mdaub/modular-vfd/README.md

# modular-vfd
A design for a modular vacuum fluorescent display using IV-11 VFD tubes
