mdaub/modular-vfd/Modular_VFD_V2_Enclosure.dxf

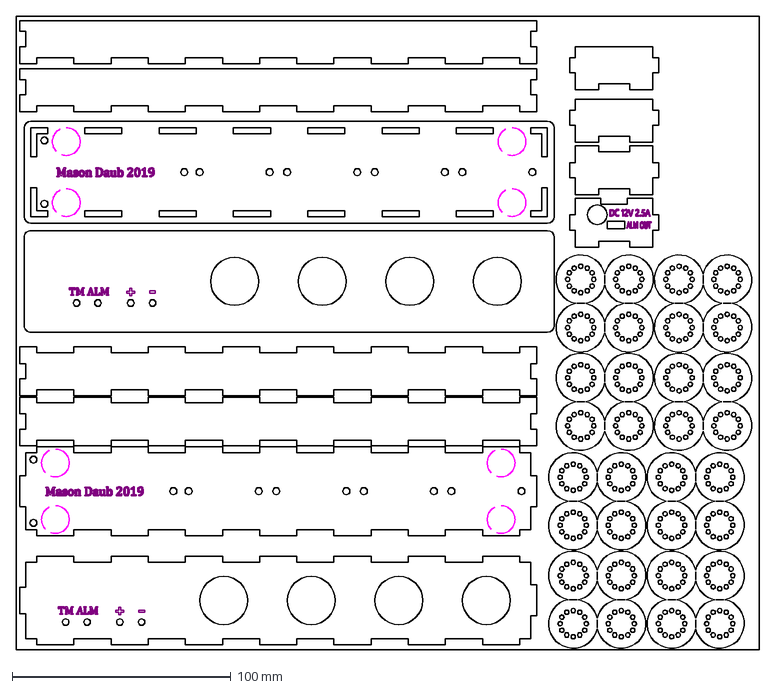
[picture p1: CAD file, 2019-11-24]
Modular_VFD_V2_Enclosure.dxf
340.0 x 290.0 mm
