mdaub/modular-vfd/Modular_VFD_V2_Enclosure_3mm.dxf

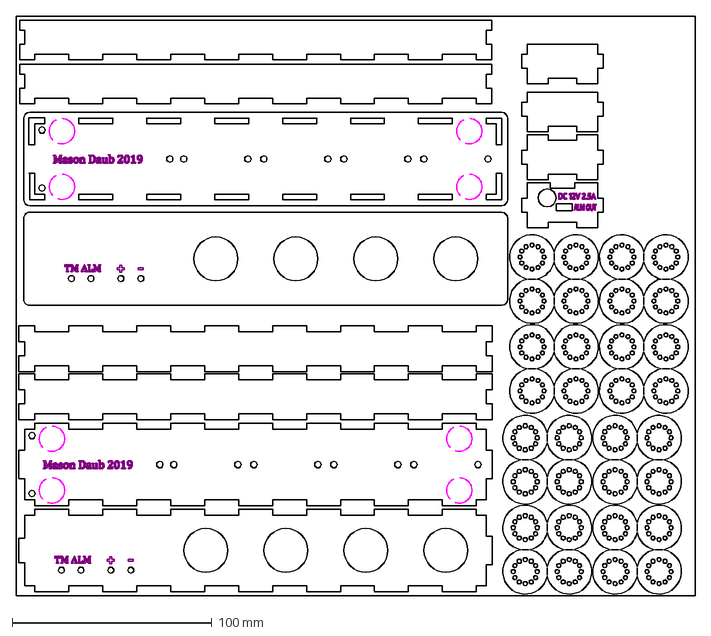
[picture p2: CAD file, 2019-11-24]
Modular_VFD_V2_Enclosure_3mm.dxf
340.0 x 290.0 mm
