mdaub/modular-vfd/VFD PSU V2.brd

## EAGLE design VFD PSU V2.brd (2019-11-23)

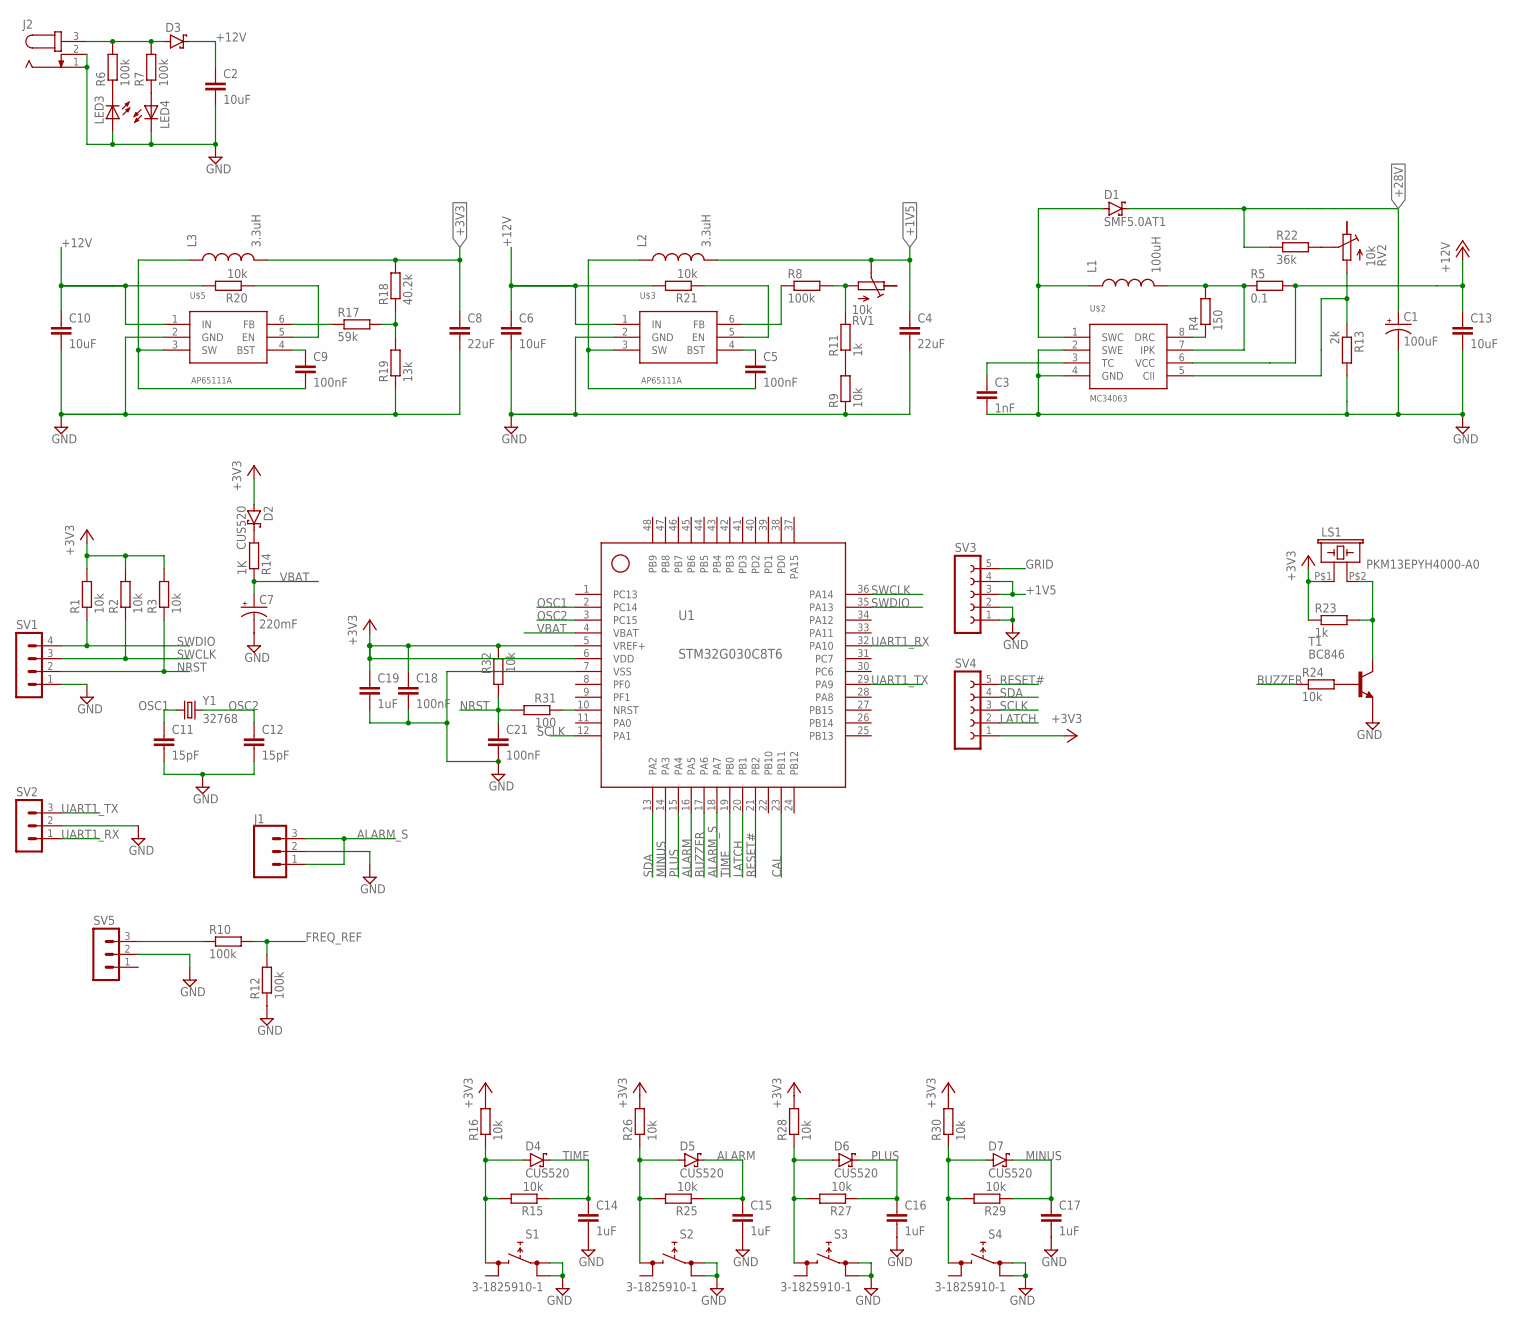
[picture p3: schematic VFD PSU V2.sch]

Parts:
C1: 100uF; PANASONIC_C
C2, C6, C10, C13: 10uF; C0805
C3: 1nF; C0603
C4, C8: 22uF; C0805
C5, C9, C18, C21: 100nF; C0603
C7: 220mF; 4.8-COINCELL-SCAP
C11, C12: 15pF; C0402
C14, C15, C16, C17, C19: 1uF; C0603
D1: SMF5.0AT1; SOD123FL
D2, D4, D5, D6, D7: CUS520; SOD323_ST
D3: SCHOTTKY-DIODESMD; SMB
J1: CONN_03JST-PTH-NS; JST-3-PTH-NS
J2: JACK-PLUG0; SPC4077
L1: 100uH; 2-SMD
L2, L3: 3.3uH; 1008
LED3, LED4: LEDSMT1206; 1206
LS1: PKM13EPYH4000-A0
R1, R2, R3, R9, R15, R16, R20, R21, R24, R25, R26, R27, R28, R29, R30, R32: 10k; R0603
R4: 150; R0603
R5: 0.1; R0805
R6, R7, R8, R10, R12: 100k; R0603
R11, R23: 1k; R0603
R13: 2k; R0603
R14: 1K; R0603
R17: 59k; R0603
R18: 40.2k; R0603
R19: 13k; R0603
R22: 36k; R0603
R31: 100; R0603
RV1, RV2: 10k; TC33X-2
S1, S2, S3, S4: 3-1825910-1; PANASONISWITCH
SV1: MA04-1
SV2, SV5: MA03-1
SV3, SV4: FE05W
T1: BC846; SOT23
U1: STM32G030C8T6; LQFP48
U$2: MC34063; SO08
U$3, U$5: AP65111A; TSOT23-6
Y1: 32768; 2-SMD-NO-LEAD-Q

Connections:
+1V5: C4.1, L2.P$2 (2), RV1.P$2 (S), SV3.3, SV3.4
+3V3: C8.1, C18.1, C19.1, D2.A, L3.P$2 (2), LS1.P$1 (1), R1.2, R2.2, R3.2, R16.2, R18.2, R23.1, R26.2, R28.2, R30.2, R32.1, SV4.1, U1.5 (VREF+), U1.6 (VDD)
+12V: C2.1, C6.1, C10.1, C13.1, D3.C, R5.2, R20.2, R21.2, U$2.6 (VCC), U$3.1 (IN), U$5.1 (IN)
+28V: C1.+, D1.C, R22.1
ALARM: C15.1, D5.C, R25.1, U1.16 (PA5)
ALARM_S: J1.1, J1.3, U1.18 (PA7)
BUZZER: R24.1, U1.17 (PA6)
CAL: U1.23 (PB11)
FREQ_REF: R10.2, R12.2
GND: C1.-, C2.2, C3.2, C4.2, C6.2, C7.P$2 (-), C8.2, C10.2, C11.2, C12.2, C13.2, C14.2, C15.2, C16.2, C17.2, C18.2, C19.2, C21.2, J1.2, J2.1, J2.2, LED3.A, LED4.C, R9.1, R12.1, R13.2, R19.1, S1.P$1 (0), S1.P$2 (0), S2.P$1 (0), S2.P$2 (0), S3.P$1 (0), S3.P$2 (0), S4.P$1 (0), S4.P$2 (0), SV1.1, SV2.2, SV3.1, SV3.2, SV5.2, T1.2 (E), U1.7 (VSS), U$2.2 (SWE), U$2.4 (GND), U$3.2 (GND), U$5.2 (GND)
GRID: SV3.5
LATCH: SV4.2, U1.20 (PB1)
MINUS: C17.1, D7.C, R29.1, U1.14 (PA3)
unnamed: LED3.C, R6.1
unnamed: LED4.A, R7.1
unnamed: R9.2, R11.1
unnamed: R8.1, U$3.6 (FB)
unnamed: L1.P$2 (2), R4.2, R5.1, U$2.7 (IPK)
unnamed: D3.A, J2.3, R6.2, R7.2
unnamed: R4.1, U$2.8 (DRC)
unnamed: R21.1, U$3.5 (EN)
unnamed: C5.2, L2.P$1 (1), U$3.3 (SW)
unnamed: C5.1, U$3.4 (BST)
unnamed: R8.2, R11.2, RV1.P$1 (E)
unnamed: D1.A, L1.P$1 (1), U$2.1 (SWC)
unnamed: R22.2, RV2.P$2 (S)
unnamed: C3.1, U$2.3 (TC)
unnamed: R10.1, SV5.3
unnamed: R20.1, U$5.5 (EN)
unnamed: C9.2, L3.P$1 (1), U$5.3 (SW)
unnamed: C9.1, U$5.4 (BST)
unnamed: D4.A, R15.2, R16.1, S1.P$3 (1)
unnamed: R17.1, U$5.6 (FB)
unnamed: R17.2, R18.1, R19.2
unnamed: R13.1, RV2.P$1 (E), U$2.5 (CII)
unnamed: D2.C, R14.2
unnamed: LS1.P$2 (2), R23.2, T1.3 (C)
unnamed: R24.2, T1.1 (B)
unnamed: D5.A, R25.2, R26.1, S2.P$3 (1)
unnamed: R31.1, U1.10 (NRST)
unnamed: D6.A, R27.2, R28.1, S3.P$3 (1)
unnamed: D7.A, R29.2, R30.1, S4.P$3 (1)
NRST: C21.1, R3.1, R31.2, R32.2, SV1.2
OSC1: C11.1, U1.2 (PC14), Y1.P$1 (1)
OSC2: C12.1, U1.3 (PC15), Y1.P$2 (2)
PLUS: C16.1, D6.C, R27.1, U1.15 (PA4)
RESET#: SV4.5, U1.21 (PB2)
SCLK: SV4.3, U1.12 (PA1)
SDA: SV4.4, U1.13 (PA2)
SWCLK: R2.1, SV1.3, U1.36 (PA14)
SWDIO: R1.1, SV1.4, U1.35 (PA13)
TIME: C14.1, D4.C, R15.1, U1.19 (PB0)
UART1_RX: SV2.1, U1.32 (PA10)
UART1_TX: SV2.3, U1.29 (PA9)
VBAT: C7.P$1 (+), R14.1, U1.4 (VBAT)

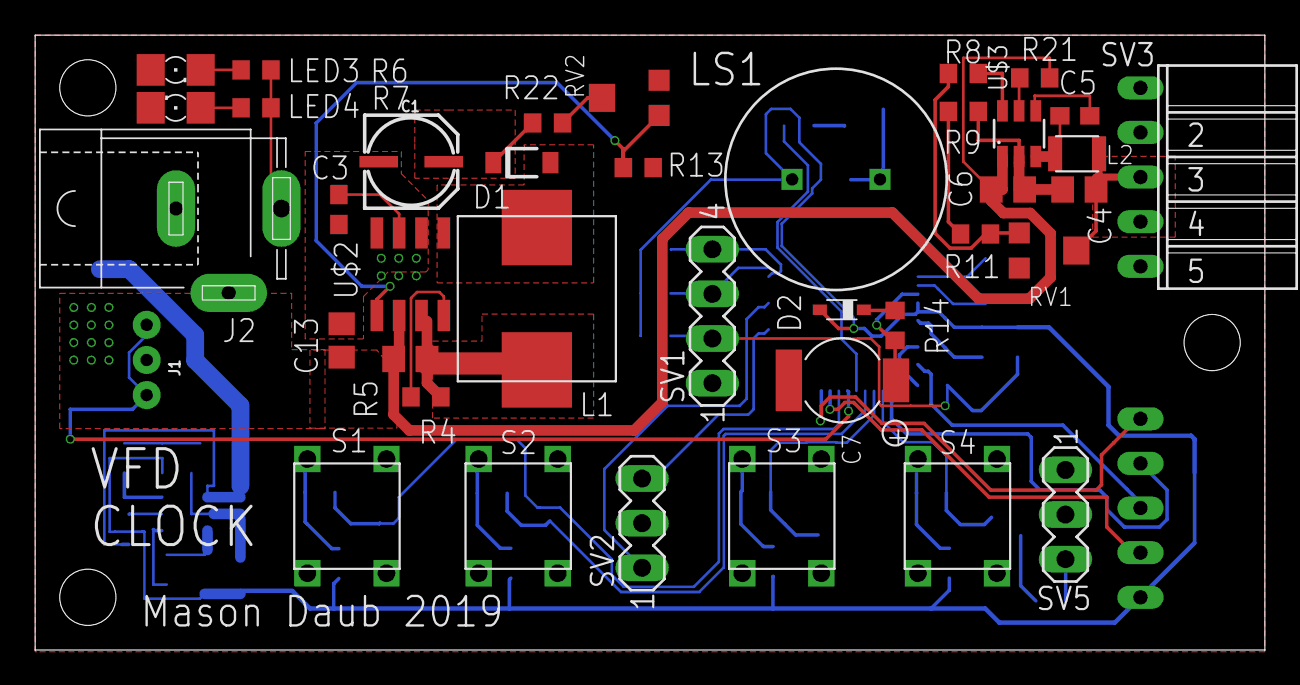
[picture p4: board VFD PSU V2.brd from above]

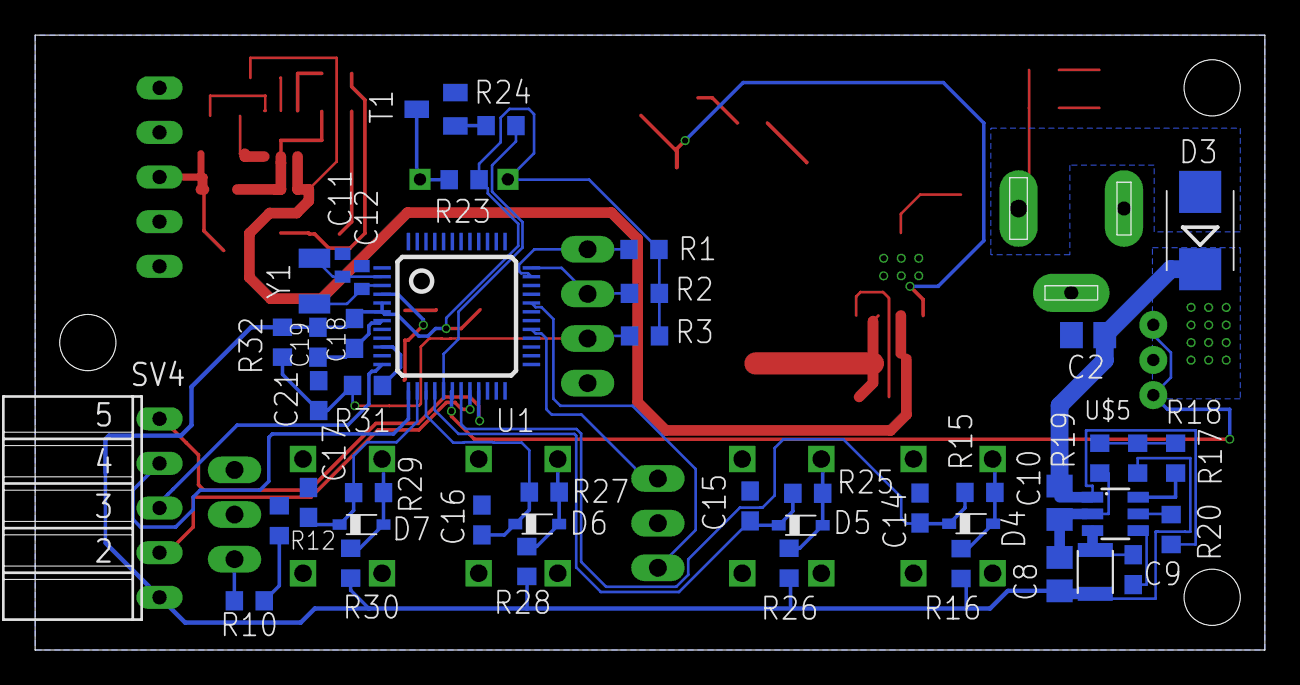
[picture p5: board VFD PSU V2.brd from below]

Board: 2 copper layers, 70.0 x 35.0 mm, 84 parts (45 on the bottom side), 53 nets.
