mdaub/modular-vfd/VFD Board.brd

## EAGLE design VFD Board.brd (2019-11-23)

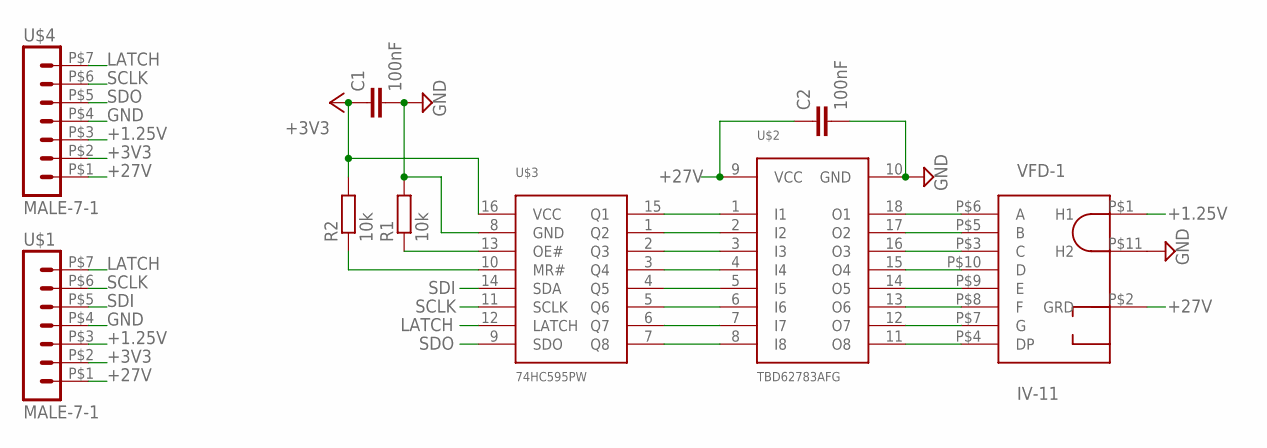
[picture p6: schematic VFD Board.sch]

Parts:
C1, C2: 100nF; C0603
R1, R2: 10k; R0603
U$1, U$4: MALE-7-1; 7-PIN-HEADER
U$2: TBD62783AFG; SOIC18L
U$3: 74HC595PW; TSSOP16
VFD-1: IV-11

Connections:
+1.25V: U$1.P$3 (3), U$4.P$3 (3), VFD-1.P$1 (H1)
+3V3: C1.1, R2.2, U$1.P$2 (2), U$3.16 (VCC), U$4.P$2 (2)
+27V: C2.1, U$1.P$1 (1), U$2.9 (VCC), U$4.P$1 (1), VFD-1.P$2 (GRD)
GND: C1.2, C2.2, R1.2, U$1.P$4 (4), U$2.10 (GND), U$3.8 (GND), U$4.P$4 (4), VFD-1.P$11 (H2)
LATCH: U$1.P$7 (7), U$3.12 (LATCH), U$4.P$7 (7)
unnamed: U$2.1 (I1), U$3.15 (Q1)
unnamed: U$2.2 (I2), U$3.1 (Q2)
unnamed: U$2.3 (I3), U$3.2 (Q3)
unnamed: U$2.4 (I4), U$3.3 (Q4)
unnamed: U$2.5 (I5), U$3.4 (Q5)
unnamed: U$2.6 (I6), U$3.5 (Q6)
unnamed: U$2.7 (I7), U$3.6 (Q7)
unnamed: U$2.8 (I8), U$3.7 (Q8)
unnamed: U$2.18 (O1), VFD-1.P$6 (A)
unnamed: U$2.17 (O2), VFD-1.P$5 (B)
unnamed: U$2.16 (O3), VFD-1.P$3 (C)
unnamed: U$2.15 (O4), VFD-1.P$10 (D)
unnamed: U$2.14 (O5), VFD-1.P$9 (E)
unnamed: U$2.13 (O6), VFD-1.P$8 (F)
unnamed: U$2.12 (O7), VFD-1.P$7 (G)
unnamed: U$2.11 (O8), VFD-1.P$4 (DP)
unnamed: R1.1, U$3.13 (OE#)
unnamed: R2.1, U$3.10 (MR#)
SCLK: U$1.P$6 (6), U$3.11 (SCLK), U$4.P$6 (6)
SDI: U$1.P$5 (5), U$3.14 (SDA)
SDO: U$3.9 (SDO), U$4.P$5 (5)

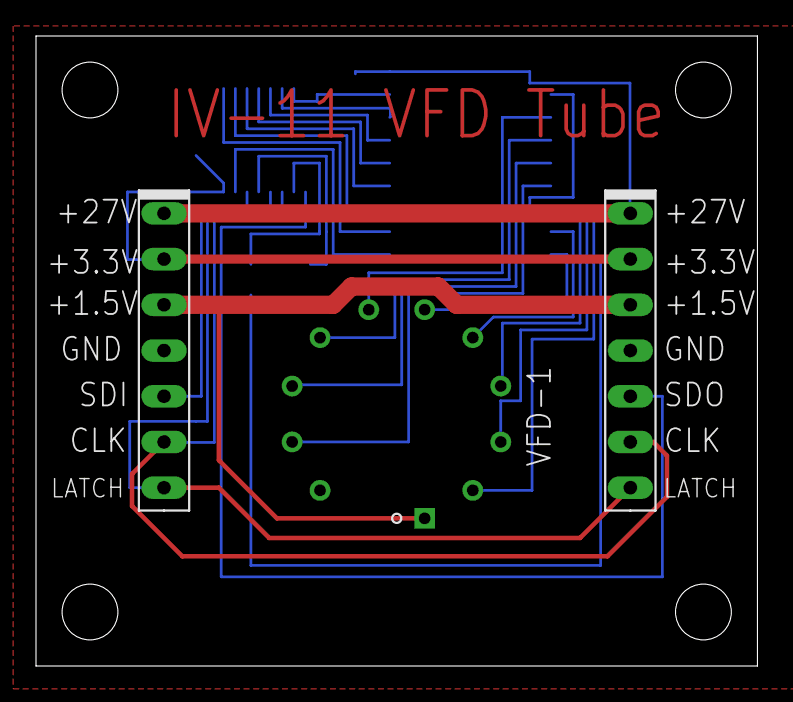
[picture p7: board VFD Board.brd from above]

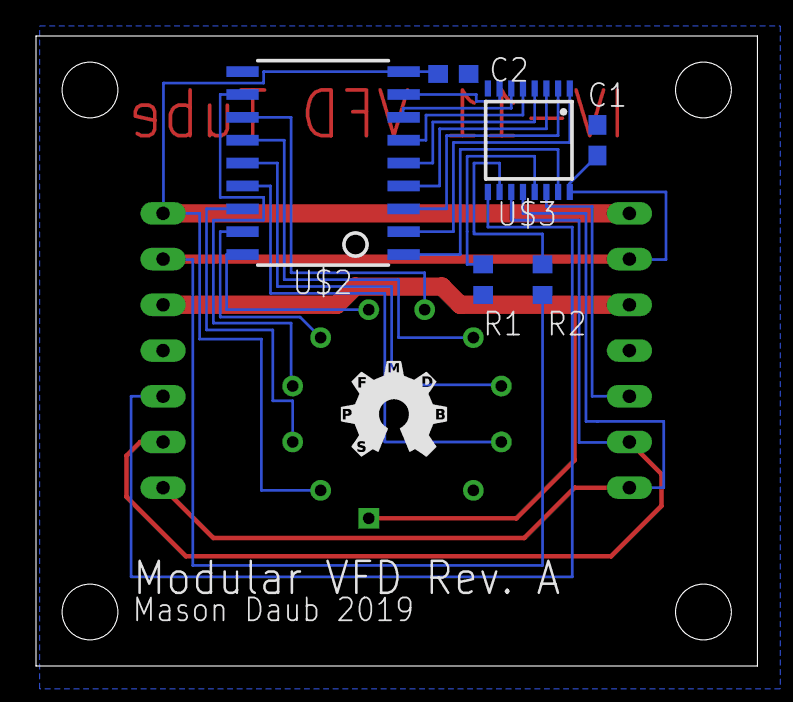
[picture p8: board VFD Board.brd from below]

Board: 2 copper layers, 40.1 x 35.0 mm, 9 parts (6 on the bottom side), 26 nets.
