mdaub/modular-vfd/VFD Board V2.brd

## EAGLE design VFD Board V2.brd (2019-11-23)

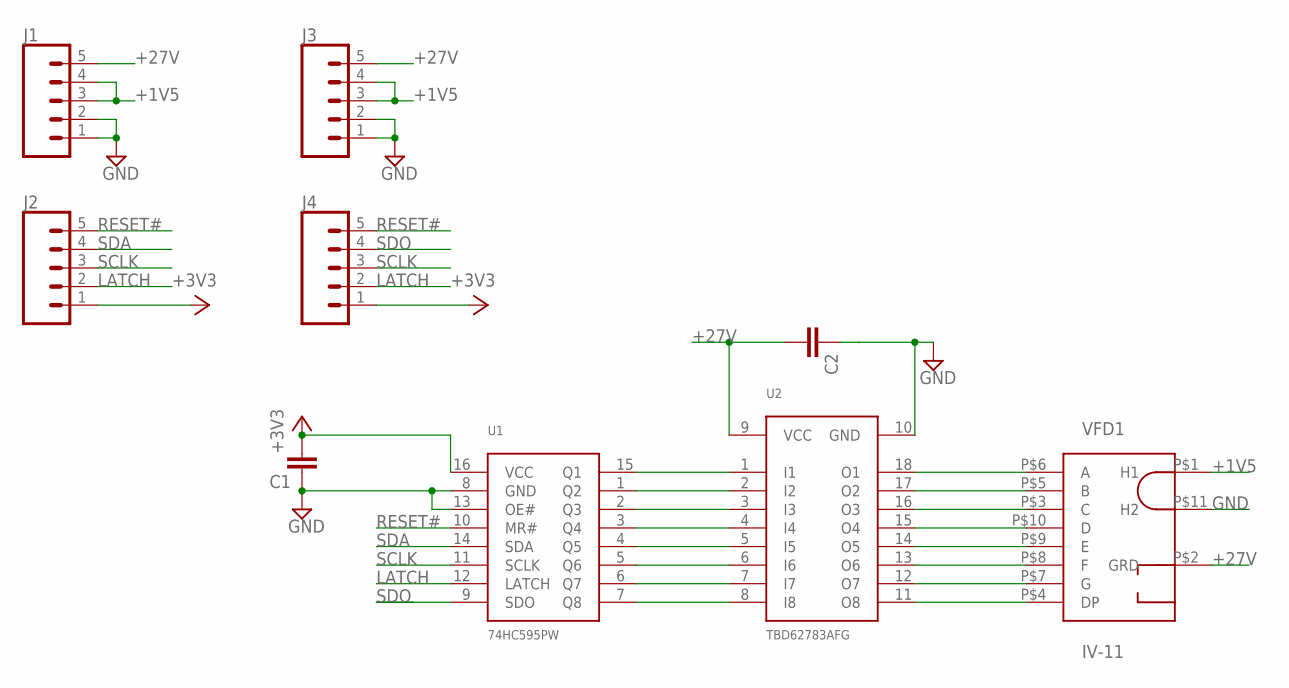
[picture p9: schematic VFD Board V2.sch]

Parts:
C1, C2: C-EUC0603; C0603
J1, J2, J3, J4: CONN_05NO_SILK; 1X05_NO_SILK
U1: 74HC595PW; TSSOP16
U2: TBD62783AFG; SOIC18L
VFD1: IV-11

Connections:
+1V5: J1.3, J1.4, J3.3, J3.4, VFD1.P$1 (H1)
+3V3: C1.2, J2.1, J4.1, U1.16 (VCC)
+27V: C2.2, J1.5, J3.5, U2.9 (VCC), VFD1.P$2 (GRD)
GND: C1.1, C2.1, J1.1, J1.2, J3.1, J3.2, U1.8 (GND), U1.13 (OE#), U2.10 (GND), VFD1.P$11 (H2)
LATCH: J2.2, J4.2, U1.12 (LATCH)
unnamed: U2.18 (O1), VFD1.P$6 (A)
unnamed: U1.7 (Q8), U2.8 (I8)
unnamed: U1.6 (Q7), U2.7 (I7)
unnamed: U1.5 (Q6), U2.6 (I6)
unnamed: U1.4 (Q5), U2.5 (I5)
unnamed: U1.3 (Q4), U2.4 (I4)
unnamed: U1.2 (Q3), U2.3 (I3)
unnamed: U1.1 (Q2), U2.2 (I2)
unnamed: U1.15 (Q1), U2.1 (I1)
unnamed: U2.17 (O2), VFD1.P$5 (B)
unnamed: U2.16 (O3), VFD1.P$3 (C)
unnamed: U2.15 (O4), VFD1.P$10 (D)
unnamed: U2.14 (O5), VFD1.P$9 (E)
unnamed: U2.13 (O6), VFD1.P$8 (F)
unnamed: U2.12 (O7), VFD1.P$7 (G)
unnamed: U2.11 (O8), VFD1.P$4 (DP)
RESET#: J2.5, J4.5, U1.10 (MR#)
SCLK: J2.3, J4.3, U1.11 (SCLK)
SDA: J2.4, U1.14 (SDA)
SDO: J4.4, U1.9 (SDO)

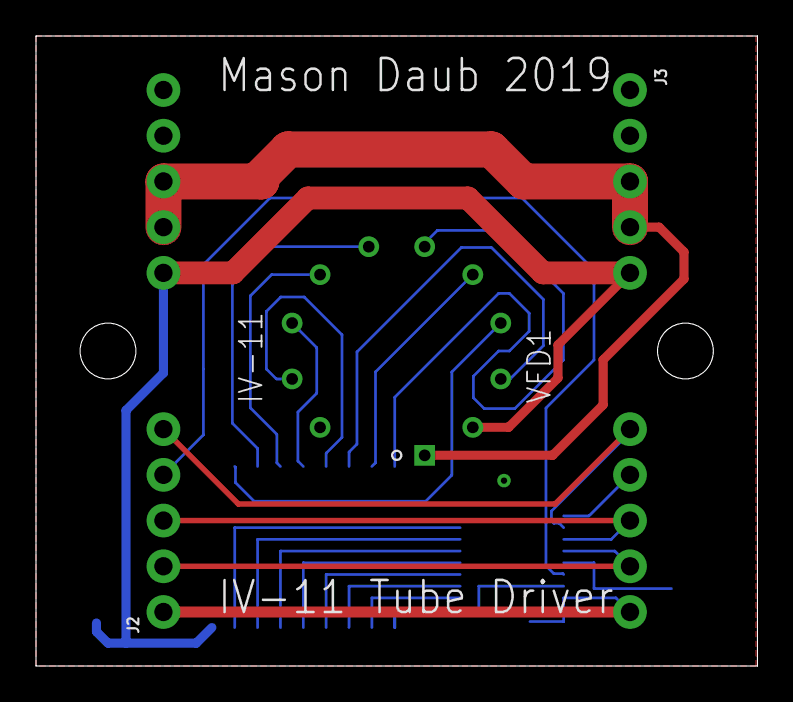
[picture p10: board VFD Board V2.brd from above]

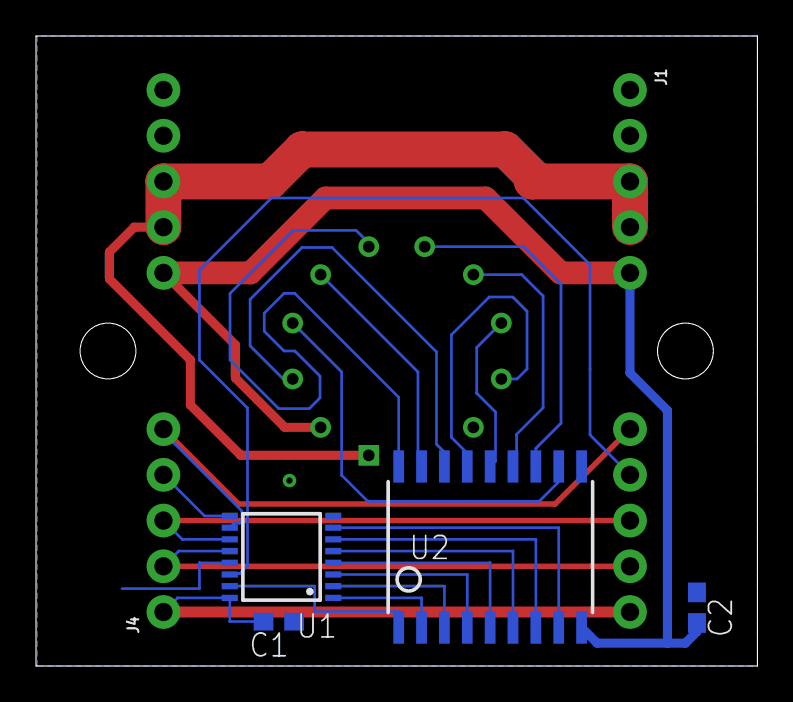
[picture p11: board VFD Board V2.brd from below]

Board: 2 copper layers, 40.1 x 35.0 mm, 9 parts (6 on the bottom side), 25 nets.
