mdaub/modular-vfd/VFD PSU.brd

## EAGLE design VFD PSU.brd (2019-11-23)

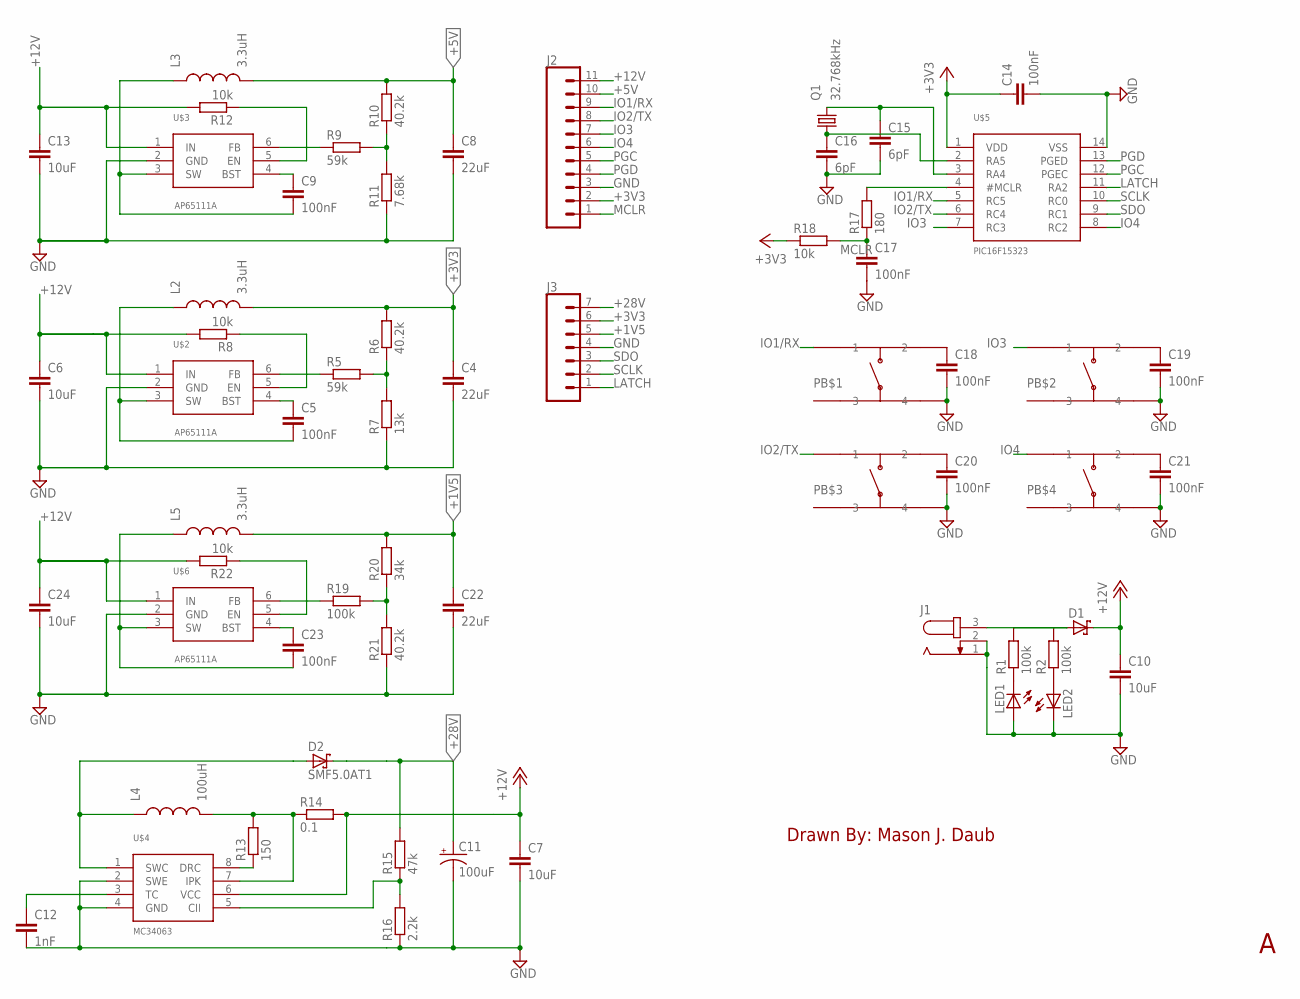
[picture p12: schematic VFD PSU.sch]

Parts:
C4, C8, C22: 22uF; C0805
C5, C9, C14, C17, C18, C19, C20, C21, C23: 100nF; C0603
C6, C7, C10, C13, C24: 10uF; C0805
C11: 100uF; PANASONIC_C
C12: 1nF; C0603
C15, C16: 6pF; C0603
D1: SCHOTTKY-DIODESMD; SMB
D2: SMF5.0AT1; SOD123FL
J1: JACK-PLUG0; SPC4077
J2: CONN_111X11_NO_SILK; 1X11_NO_SILK
J3: CONN_07LONGPADS; 1X07_LONGPADS
L2, L3, L5: 3.3uH; 1008
L4: 100uH; 2-SMD
LED1, LED2: LEDSMT1206; 1206
PB$1, PB$2, PB$3, PB$4: PTS645SM43SMTR92-LFS; SMDTACTILE
Q1: 32.768kHz; 8.2X3.8
R1, R2, R19: 100k; R0603
R5, R9: 59k; R0603
R6, R10, R21: 40.2k; R0603
R7: 13k; R0603
R8, R12, R18, R22: 10k; R0603
R11: 7.68k; R0603
R13: 150; R0603
R14: 0.1; R0805
R15: 47k; R0603
R16: 2.2k; R0603
R17: 180; R0603
R20: 34k; R0603
U$2, U$3, U$6: AP65111A; TSOT23-6
U$4: MC34063; SO08
U$5: PIC16F15323; SO14

Connections:
+1V5: C22.1, J3.5, L5.P$2 (2), R20.2
+3V3: C4.1, C14.1, J2.2, J3.6, L2.P$2 (2), R6.2, R18.1, U$5.1 (VDD)
+5V: C8.1, J2.10, L3.P$2 (2), R10.2
+12V: C6.1, C7.1, C10.1, C13.1, C24.1, D1.C, J2.11, R8.2, R12.2, R14.2, R22.2, U$2.1 (IN), U$3.1 (IN), U$4.6 (VCC), U$6.1 (IN)
+28V: C11.+, D2.C, J3.7, R15.2
GND: C4.2, C6.2, C7.2, C8.2, C10.2, C11.-, C12.2, C13.2, C14.2, C15.2, C16.2, C17.2, C18.2, C19.2, C20.2, C21.2, C22.2, C24.2, J1.1, J1.2, J2.3, J3.4, LED1.A, LED2.C, PB$1.P$4 (4), PB$2.P$4 (4), PB$3.P$4 (4), PB$4.P$4 (4), R7.1, R11.1, R16.1, R21.1, U$2.2 (GND), U$3.2 (GND), U$4.2 (SWE), U$4.4 (GND), U$5.14 (VSS), U$6.2 (GND)
IO1/RX: J2.9, PB$1.P$1 (1), U$5.5 (RC5)
IO2/TX: J2.8, PB$3.P$1 (1), U$5.6 (RC4)
IO3: J2.7, PB$2.P$1 (1), U$5.7 (RC3)
IO4: J2.6, PB$4.P$1 (1), U$5.8 (RC2)
LATCH: J3.1, U$5.11 (RA2)
MCLR: C17.1, J2.1, R17.1, R18.2
unnamed: R15.1, R16.2, U$4.5 (CII)
unnamed: D1.A, J1.3, R1.2, R2.2
unnamed: LED2.A, R2.1
unnamed: L4.P$2 (2), R13.2, R14.1, U$4.7 (IPK)
unnamed: LED1.C, R1.1
unnamed: R8.1, U$2.5 (EN)
unnamed: C5.2, L2.P$1 (1), U$2.3 (SW)
unnamed: C5.1, U$2.4 (BST)
unnamed: R5.1, U$2.6 (FB)
unnamed: R5.2, R6.1, R7.2
unnamed: R13.1, U$4.8 (DRC)
unnamed: R12.1, U$3.5 (EN)
unnamed: C9.2, L3.P$1 (1), U$3.3 (SW)
unnamed: C9.1, U$3.4 (BST)
unnamed: R9.1, U$3.6 (FB)
unnamed: R9.2, R10.1, R11.2
unnamed: D2.A, L4.P$1 (1), U$4.1 (SWC)
unnamed: C15.1, Q1.4 (2), U$5.3 (RA4)
unnamed: C16.1, Q1.1, U$5.2 (RA5)
unnamed: C12.1, U$4.3 (TC)
unnamed: R17.2, U$5.4 (#MCLR)
unnamed: C18.1, PB$1.P$2 (2)
unnamed: R22.1, U$6.5 (EN)
unnamed: C19.1, PB$2.P$2 (2)
unnamed: C23.2, L5.P$1 (1), U$6.3 (SW)
unnamed: C20.1, PB$3.P$2 (2)
unnamed: C23.1, U$6.4 (BST)
unnamed: C21.1, PB$4.P$2 (2)
unnamed: R19.1, U$6.6 (FB)
unnamed: R19.2, R20.1, R21.2
PGC: J2.5, U$5.12 (PGEC)
PGD: J2.4, U$5.13 (PGED)
SCLK: J3.2, U$5.10 (RC0)
SDO: J3.3, U$5.9 (RC1)

Notes on the sheet:
Drawn By: Mason J. Daub

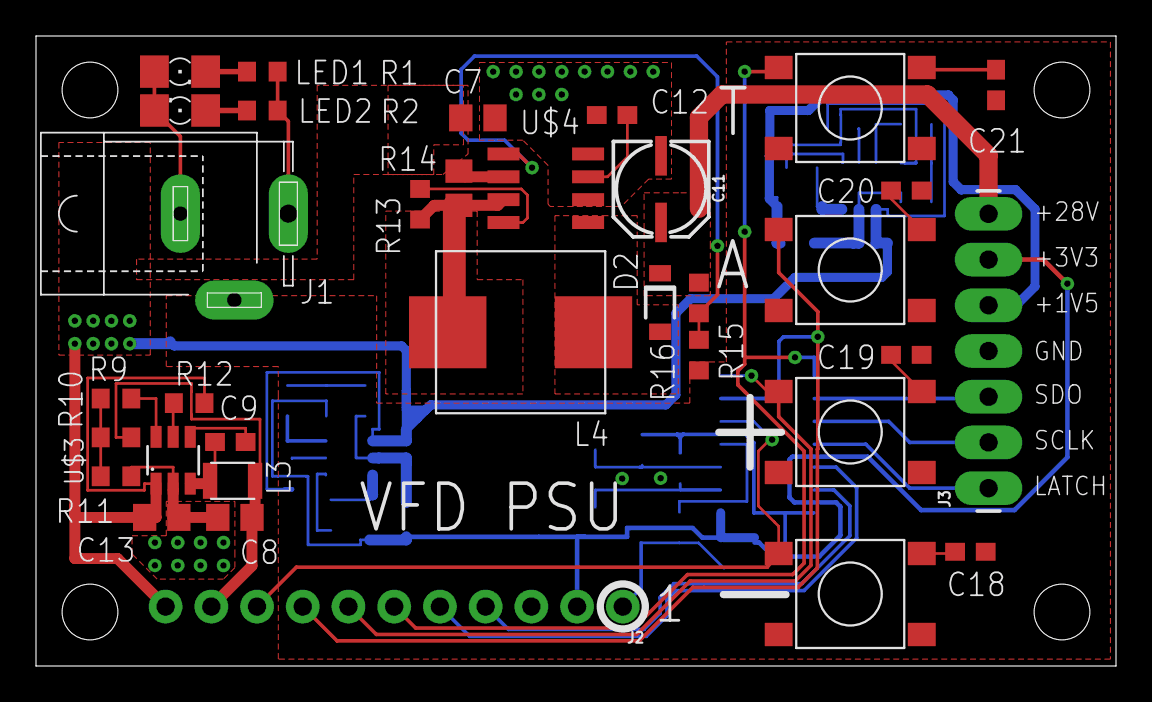
[picture p13: board VFD PSU.brd from above]

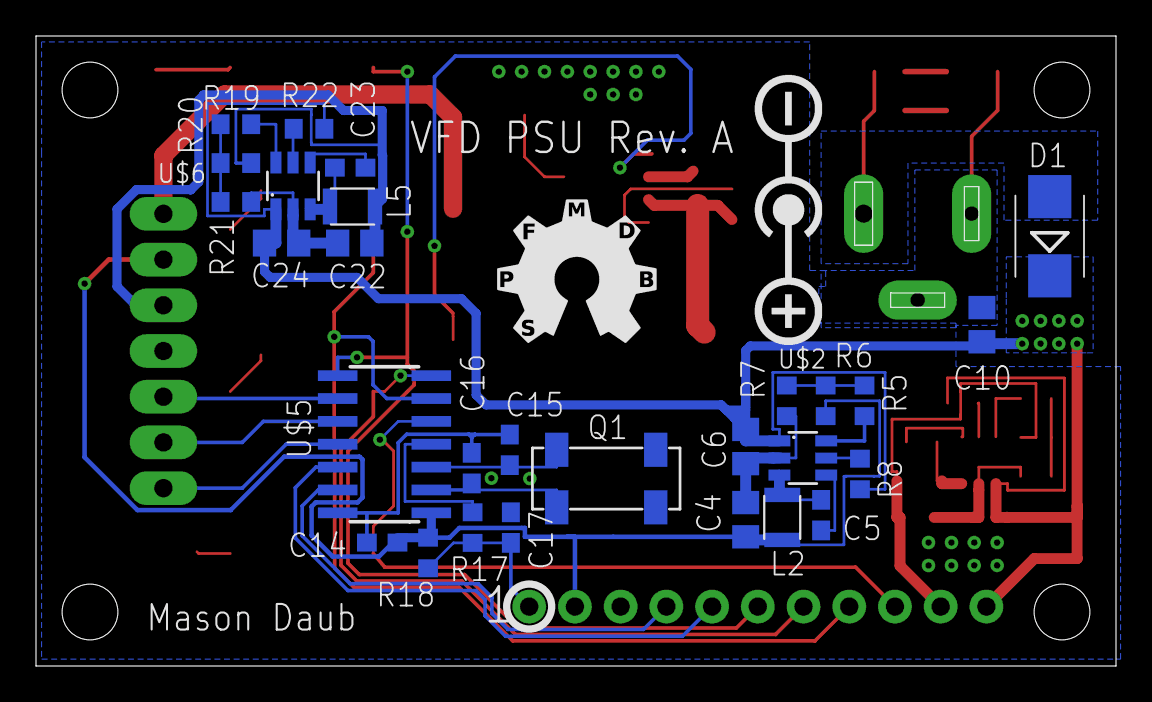
[picture p14: board VFD PSU.brd from below]

Board: 2 copper layers, 60.0 x 35.0 mm, 62 parts (28 on the bottom side), 46 nets.
