mdaub/modular-vfd/(commit log)

2019-11-23 Adding existing files
    [Modular_VFD_V2_Enclosure.dxf, VFD Board V2.brd, VFD Board V2.sch, VFD Board.brd, VFD Board.sch, VFD PSU V2.brd, VFD PSU V2.sch, VFD PSU.brd]
2019-11-24 Optimised area, preparing for manufacturing
    [Modular_VFD_V2_Enclosure.dxf, Modular_VFD_V2_Enclosure_3mm.dxf]
