mdaub/modular-vfd/(notices)

Notices in the files:
parts and their libraries:
SparkFun-Capacitors: Licensing: Creative Commons ShareAlike 4.0 International - https://creativecommons.org/licenses/by-sa/4.0
crystal-geyer_V1_0: Copyright: Geyer-Electronic
